dezash123/watch-pcb/mainboard/watch-pcb.kicad_pcb

## KiCad design mainboard/watch-pcb.kicad_pcb (2025-09-04)

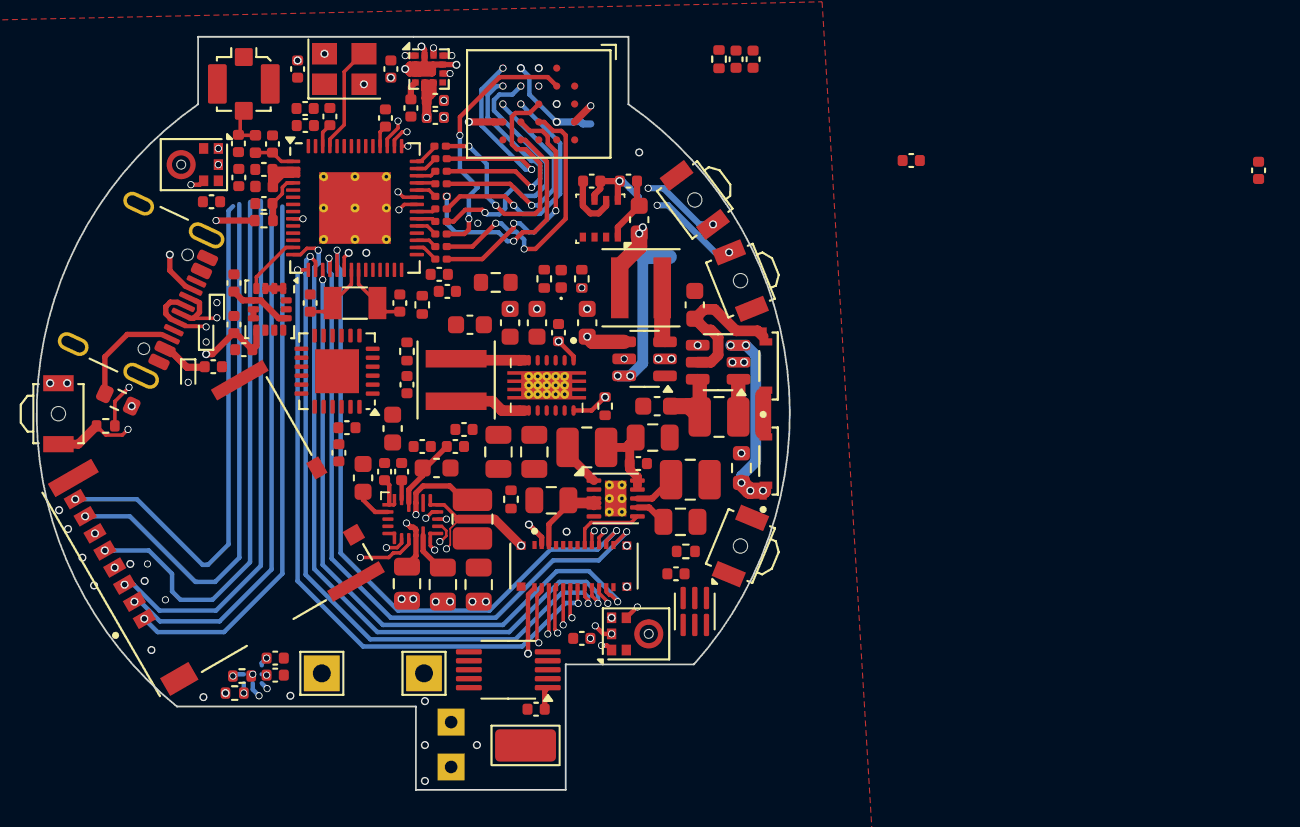
[picture p1: board watch-pcb.kicad_pcb from above]

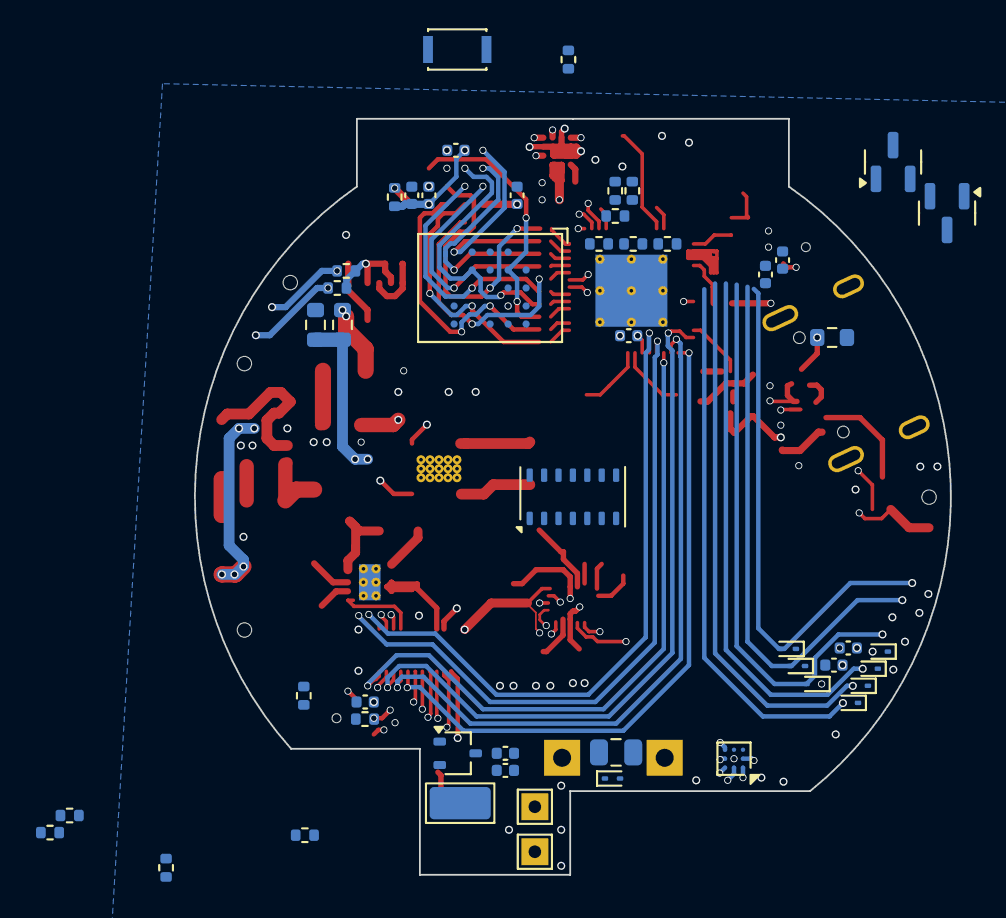
[picture p2: board watch-pcb.kicad_pcb from below]

Board: 6 copper layers, 42.0 x 42.0 mm, 179 parts (50 on the bottom side), 116 nets.

Parts:
C1, C4, C9, C17, C19, C23, C27, C41, C44, C48, C52, C70, C72, C75, C78: 1uF; C_0402_1005Metric
C2, C10, C11, C13, C14, C16, C24, C25, C26, C28, C29, C30, C35, C45, C50, C54, C56, C59, C61, C62, C67, C68, C69, C71, C74, C76, C77: 100nF; C_0402_1005Metric
C3, C84: 10uF; C_0603_1608Metric
C5: 47nF; C_0402_1005Metric
C6, C7, C8: 22uF; C_0603_1608Metric
C12, C73, C81: 4.7uF; C_0603_1608Metric
C15, C55, C57, C58, C64, C65, C79, C80: 10uF; C_0805_2012Metric
C18, C33: 10nF; C_0402_1005Metric
C20: 2.2uF; C_0402_1005Metric
C21, C22: 1.5pF; C_0402_1005Metric
C31, C32, C46, C47: C; C_0402_1005Metric
C34, C60: 10uF; C_0402_1005Metric
C51: 1uF; C_0603_1608Metric
C63: 22uF; C_0805_2012Metric
C82: 220nF; C_0603_1608Metric
D1, D2: CUW Y3SH.B2-JD-42-6T; LED_CUW_Y3SH.B2-GFJD-5J6T-Z242-20-R18-Z
D3, D6, D7, D8: ESD9B5.0ST5G; D_SOD-923
D4: CHARGING; LED_0402_1005Metric
D9, D10, D11, D12, D13, D14, D15: ESD9B3.3ST5G; D_SOD-923
J2: USB_C_Receptacle; USB_C_Receptacle_GCT_USB4105-xx-A_16P_TopMnt_Horizontal
J3: ESP_ANT; U.FL_Molex_MCRF_73412-0110_Vertical
J5: Micro_SD_Card; MOLEX_503398-1892
J6: TT143AMC12C; MOLEX_505550-2420
J7: BATT+; TestPoint_THTPad_2.0x2.0mm_Drill1.0mm
J8: BATT-; TestPoint_THTPad_2.0x2.0mm_Drill1.0mm
J9: LASER+; TestPoint_Keystone_5015_Micro_Mini
J10: LASER-; TestPoint_Keystone_5015_Micro_Mini
J11: MTR+; TestPoint_THTPad_1.5x1.5mm_Drill0.7mm
J13: MTR-; TestPoint_THTPad_1.5x1.5mm_Drill0.7mm
L1: XFL4020-152ME; L_Coilcraft_XxL4040
L2: CIGT252010EH1R0MNE; L_1008_2520Metric
L3: XFL4020-222ME; L_Coilcraft_XxL4040
L4: 2.7nH; L_0402_1005Metric
L5: LQG15HN2N0C02D; L_0402_1005Metric
L6: 24nH; C_0402_1005Metric
L7, L8: 10uH; L_1008_2520Metric
L9: LQM2HPN4R7MG0L; L_1008_2520Metric
MK1, MK2: ICS-43434; InvenSense_ICS-43434-6_3.5x2.65mm
Q1: BSS214NW; SOT-323_SC-70
Q2, Q3: BSS138; SOT-23
R1, R18, R23, R24, R38, R39, R40, R41, R42, R43: 10k; R_0402_1005Metric
R4: 5; R_0603_1608Metric
R5, R14, R15, R17, R19, R20, R45, R46, R47, R48, R49: 100k; R_0402_1005Metric
R8, R35, R37, R44, R50, R51, R52, R53, R54, R55: 0; R_0201_0603Metric
R9: 5k; R_0402_1005Metric
R10: 1M; R_0402_1005Metric
R11: 5.32k; R_0402_1005Metric
R12: 30.1; R_0402_1005Metric
R13: R; R_0402_1005Metric
R16, R22: 5.1k; R_0603_1608Metric
R26: 0; R_0402_1005Metric
R28: 200k; R_0603_1608Metric
R29: 100k; R_0603_1608Metric
R30: 499k; R_0402_1005Metric
R36: 1k; C_0402_1005Metric
SW1, SW2, SW3, SW4: B3U-3000P-B; SW_SPST_B3U-3000P-B
SW8: BOOT; SW_SPST_CK_KXT3
TH1: 103AT-2 10k; R_0603_1608Metric
U1: TPS63021; Texas_VSON-14_3x4mm_ThermalPad
U2: BQ25628E; Texas_WQFN-18_2.5x3.0mm_P0.4mm
U3: BME280; Bosch_LGA-8_2.5x2.5mm_P0.65mm_ClockwisePinNumbering
U4: BQ27427YZFR; Texas_DSBGA-9_1.62x1.58mm_Layout3x3_P0.5mm
U5: MX25UM51245GXDI00; BGA-24_6.0x8.0mm_Layout5x5_P1.0mm
U6: S80KS5123GABHV020; BGA-24_6.0x8.0mm_Layout5x5_P1.0mm
U8: TCA9535MRGER; VQFN-24-1EP_4x4mm_P0.5mm_EP2.45x2.45mm
U9: TPS65631W; WSON-10-1EP_2.5x2.5mm_P0.5mm_EP1.2x2mm_ThermalVias
U10: LIS3MDL; LGA-12_2x2mm_P0.5mm
U11: ESP32-S3; QFN-56-1EP_7x7mm_P0.4mm_EP4x4mm_ThermalVias
U12: LSM6DSOXTR; LGA-14_3x2.5mm_P0.5mm_LayoutBorder3x4y
U13: DRV2605LDGS; VSSOP-10_3x3mm_P0.5mm
U14: MAX30102; Maxim_OLGA-14_3.3x5.6mm_P0.8mm
U15: APDS-9306-065; Broadcom_DFN-6_2x2mm_P0.65mm
U16: AP3019AK; SOT-23-6
U17: TLV62569DDC; SOT-23-6
Y1: 32.768kHz; Crystal_SMD_3215-2Pin_3.2x1.5mm
Y2: 40MHz(10ppm); Crystal_SMD_3225-4Pin_3.2x2.5mm

Connections:
+1V8: C9.1, C10.1, C23.1, C24.2, C25.1, C26.1, C27.1, C28.1, C29.1, C30.1, C72.2, C76.2, C84.2, L3.2, R19.1, R20.1, R28.1, U5.B4 (VCC), U5.D1 (VCCQ), U5.E4 (VCCQ), U6.B4 (VCC), U6.D1 (VCCQ), U6.E4 (VCCQ), U11.29 (VDD_SPI), U14.11 (VDD)
+3V3: C4.1, C6.2, C7.2, C8.2, C11.1, C13.1, C16.1, C17.1, C33.1, C34.1, C44.2, C45.1, C48.2, C50.2, C52.2, C54.1, C55.2, C56.1, C60.2, C61.2, C62.1, C67.2, C68.2, C69.2, C70.2, C73.1, C74.1, C77.1, D15.2 (A2), J5.4 (VDD), J6.1 (VDD), J6.19 (IOVCC), J6.20 (VDD), J9.1, L5.2, L7.1, MK1.5 (VDD), MK2.2 (LR), MK2.5 (VDD), R5.2, R10.1, R13.2, R15.2, R17.2, R24.2, R38.1, R39.1, R40.1, R41.1, R42.1, R43.1, R46.1, R47.1, R48.1, R49.1, SW8.1, U1.3 (FB), U1.4 (VOUT), U1.5 (VOUT), U3.2 (CSB), U3.6 (VDDIO), U3.8 (VDD), U8.21 (VCC), U9.9 (AVIN), U9.10 (PVIN), U10.5 (Vdd), U10.6 (Vdd_IO), U10.10 (~CS), U11.20 (VDD3P3_RTC), U11.46 (VDD3P3_CPU), U11.55 (VDDA), U11.56 (VDDA), U12.5 (VDDIO), U12.8 (VDD), U12.12 (CS), U14.9 (VLED+), U14.10 (VLED+), U15.3 (VDD)
+BATT: C15.2, C19.2, C63.1, D3.2 (A2), J7.1, U2.8 (BAT), U4.C3 (BAT)
+VSW: C2.2, C51.1, C64.1, C65.1, C71.2, C75.1, C79.1, C80.1, C81.1, L2.2, L9.2, R30.2, U1.1 (VINA), U1.10 (VIN), U1.11 (VIN), U2.9 (SYS), U4.C2 (SRX), U13.6 (VDD/NC), U13.10 (VDD), U16.6 (V_{IN}), U17.1 (EN), U17.4 (VIN)
/ESP MCU/BOOT: Q2.1 (G), Q3.1 (G), R1.2, SW8.2
/ESP MCU/CLK_N: C47.2, U11.53 (XTAL_N), Y2.3
/ESP MCU/CLK_P: L6.2, U11.54 (XTAL_P)
/ESP MCU/EN: R10.2, R23.1, U1.14 (PG)
/ESP MCU/ESP_ANT: C22.1, L4.2, U11.1 (LNA_IN)
/ESP MCU/EXT_INT: R24.1, U8.22 (~INT), U11.27 (GPIO21)
/ESP MCU/EXT_IO1: U8.1 (P00), U13.5 (EN)
/ESP MCU/EXT_IO2: J6.5 (RST), U8.2 (P01)
/ESP MCU/EXT_IO3: J6.15 (RST), U8.3 (P02)
/ESP MCU/EXT_IO4: U8.4 (P03), U12.9 (INT2)
/ESP MCU/EXT_IO5: R47.2, SW2.1, U8.5 (P04)
/ESP MCU/EXT_IO6: R48.2, SW3.2, U8.6 (P05)
/ESP MCU/EXT_IO7: R49.2, SW4.1, U8.7 (P06)
/ESP MCU/EXT_IO8: R5.1, U8.8 (P07), U15.4 (INT)
/ESP MCU/EXT_IO9: U8.10, U10.7 (INT)
/ESP MCU/EXT_IO10: R14.1, U1.13 (PS/SYNC), U8.11
/ESP MCU/EXT_IO11: R15.1, U2.11 (INT), U8.12
/ESP MCU/EXT_IO12: R17.1, U4.A1 (GPOUT), U8.13
/ESP MCU/FSPI_CLK: J6.11 (SCL), U11.17 (GPIO12)
/ESP MCU/FSPI_CS: J6.7 (CS), U11.15 (GPIO10)
/ESP MCU/FSPI_D: J6.8 (D0), U11.16 (GPIO11)
/ESP MCU/FSPI_HD: J6.9 (D3), U11.14 (GPIO9)
/ESP MCU/FSPI_Q: J6.13 (D1), U11.18 (GPIO13)
/ESP MCU/FSPI_WP: J6.14 (D2), U11.19 (GPIO14)
/ESP MCU/I2S_SCK: MK1.4 (SCK), MK2.4 (SCK), U11.45 (MTDO)
/ESP MCU/I2S_SD: MK1.6 (SD), MK2.6 (SD), R45.2, U11.43 (GPIO38)
/ESP MCU/I2S_WS: MK1.1 (WS), MK2.1 (WS), U11.44 (MTCK)
/ESP MCU/IO1: R26.2, U11.9 (GPIO4)
/ESP MCU/IO2: J6.2 (INT), U11.10 (GPIO5)
/ESP MCU/IO3: J6.16 (TE), U11.11 (GPIO6)
/ESP MCU/IO4: R46.2, U11.12 (GPIO7), U14.13 (~INT)
/ESP MCU/IO5: U11.13 (GPIO8), U12.4 (INT1)
/ESP MCU/IO6: R36.1, U11.23 (GPIO17)
/ESP MCU/IO8: U10.8 (DRDY), U11.37 (SPICLK_P)
/ESP MCU/IO9: U11.36 (SPICLK_N), U16.4 (CTRL)
/ESP MCU/MCU_SCL: Q3.3 (D), U11.5 (GPIO0)
/ESP MCU/MEM_CLK: R52.2, U5.B2 (SCLK), U6.B2 (CK)
/ESP MCU/MEM_CS0: U5.C2 (CS#), U11.32 (SPICS0)
/ESP MCU/MEM_CS1: U6.A3 (CS#), U11.28 (SPICS1)
/ESP MCU/MEM_D0: R54.2, U5.D3 (SIO0), U6.D3 (DQ0)
/ESP MCU/MEM_D1: R53.2, U5.D2 (SIO1), U6.D2 (DQ1)
/ESP MCU/MEM_D2: R51.2, U5.C4 (SIO2), U6.C4 (DQ2)
/ESP MCU/MEM_D3: R50.2, U5.D4 (SIO3), U6.D4 (DQ3)
/ESP MCU/MEM_D4: R8.2, U5.D5 (SIO4), U6.D5 (DQ4)
/ESP MCU/MEM_D5: R35.2, U5.E3 (SIO5), U6.E3 (DQ5)
/ESP MCU/MEM_D6: R37.2, U5.E2 (SIO6), U6.E2 (DQ6)
/ESP MCU/MEM_D7: R44.2, U5.E1 (SIO7), U6.E1 (DQ7)
/ESP MCU/MEM_DQS: R55.2, U5.C3 (DQS), U6.C3 (RWDS)
/ESP MCU/RTC_N: C32.2, U11.22 (XTAL_32K_N), Y1.1
/ESP MCU/RTC_P: C31.2, U11.21 (XTAL_32K_P), Y1.2
/ESP MCU/SD_CLK: D12.2 (A2), J5.5 (CLK), R41.2, U11.50 (U0RXD)
/ESP MCU/SD_CMD: D11.2 (A2), J5.3 (CMD), R40.2, U11.49 (U0TXD)
/ESP MCU/SD_D0: D13.2 (A2), J5.7 (DAT0), R42.2, U11.51 (GPIO45)
/ESP MCU/SD_D1: D14.2 (A2), J5.8 (DAT1), Q2.3 (D), R43.2, U11.52 (GPIO46)
/ESP MCU/SD_D2: D9.2 (A2), J5.1 (DAT2), R38.2, U11.47 (MTDI)
/ESP MCU/SD_D3: D10.2 (A2), J5.2 (DAT3/CD), R39.2, U11.48 (MTMS)
/ESP MCU/USB_D+: D7.2 (A2), J2.A6 (D+), J2.B6 (D+), U11.26 (GPIO20/USB_D+)
/ESP MCU/USB_D-: D8.2 (A2), J2.A7 (D-), J2.B7 (D-), U11.25 (GPIO19/USB_D-)
/IO/AMOLED_M: C58.2, J6.23 (ELVSS), U9.7 (OUTN)
/IO/AMOLED_P: C57.2, J6.22 (ELVDD), U9.3 (OUTP), U9.4 (FBS)
/IO/SWIRE: J6.17 (SWIRE), U9.6 (CTRL)
/USB and Power/1V8G: R30.1, U1.12 (EN), U17.5 (PG)
/USB and Power/SCL: U2.13 (SCL), U4.A3 (SCL)
/USB and Power/SDA: U2.12 (SDA), U4.A2 (SDA)
GND: C1.2, C2.1, C3.1, C4.2, C6.1, C7.1, C8.1, C9.2, C10.2, C11.2, C12.2, C13.2, C14.2, C15.1, C16.2, C17.2, C18.2, C19.1, C20.1, C21.2, C22.2, C23.2, C24.1, C25.2, C26.2, C27.2, C28.2, C29.2, C30.2, C31.1, C32.1, C33.2, C34.2, C35.2, C41.2, C44.1, C45.2, C46.2, C47.1, C48.1, C50.1, C51.2, C52.1, C54.2, C55.1, C56.2, C57.1, C58.1, C59.1, C60.1, C61.1, C62.2, C63.2, C64.2, C65.2, C67.1, C68.1, C69.1, C70.1, C71.1, C72.1, C73.2, C74.2, C75.2, C76.1, C77.2, C78.2, C79.2, C80.2, C81.2, C82.2, C84.1, D3.1 (A1), D6.2 (A2), D7.1 (A1), D8.1 (A1), D9.1 (A1), D10.1 (A1), D11.1 (A1), D12.1 (A1), D13.1 (A1), D14.1 (A1), D15.1 (A1), J2.A1 (GND), J2.A12 (GND), J2.B1 (GND), J2.B12 (GND), J2.S1 (SHIELD), J3.2 (Ext), J5.6 (VSS), J5.9 (SHIELD), J6.6 (GND), J6.10 (GND), J6.12 (GND), J6.18 (GND), J6.24 (MTP_PWR), J6.SH (SHIELD), J8.1, L8.1, MK1.2 (LR), MK1.3 (GND), MK2.3 (GND), Q1.2 (S), Q2.2 (S), Q3.2 (S), R1.1, R4.2, R9.2, R12.1, R14.2, R16.2, R18.1, R22.2, R29.2, R45.1, SW1.2, SW2.2, SW3.1, SW4.2, TH1.1, U1.2 (GND), U1.15 (PGND), U2.14 (CE), U2.15 (GND), U3.1 (GND), U3.5 (SDO), U3.7 (GND), U4.B2 (VSS), U4.C1 (VSS), U5.B3 (GND), U5.C1 (VSSQ), U5.E5 (VSSQ), U6.B1 (CK#), U6.B3 (VSS), U6.C1 (VSSQ), U6.E5 (VSSQ), U8.9 (GND), U8.18 (A0), U8.23 (A1), U8.24 (A2), U8.25 (EPAD), U9.2 (PGND), U9.5 (AGND), U9.11 (GND), U10.2 (GND), U10.3 (GND), U10.9 (SDO/SA1), U10.12 (GND), U11.57 (GND), U12.1 (SDO/SA0), U12.2 (SDX), U12.3 (SCX), U12.6 (GND), U12.7 (GND__1), U13.4 (IN/TRIG), U13.8 (GND), U14.4 (PGND), U14.12 (GND), U15.6 (GND), U16.2 (GND), U17.2 (GND), Y2.2, Y2.4
unnamed: C14.1, L5.1, U11.2 (VDD3P3), U11.3 (VDD3P3)
unnamed: C46.1, L6.1, Y2.1
unnamed: C82.1, D1.2 (A), U16.5 (V_{OUT})
unnamed: D1.1 (K), D2.2 (A)
unnamed: D2.1 (K), R4.1, U16.3 (FB)
unnamed: D4.2 (A), R13.1
unnamed: D4.1 (K), U2.10 (STAT)
unnamed: J2.A5 (CC1), R16.1
unnamed: J2.B5 (CC2), R22.1
unnamed: C21.1, J3.1 (In), L4.1
unnamed: J10.1, Q1.3 (D)
unnamed: J11.1, U13.7 (OUT+)
unnamed: J13.1, U13.9 (OUT-)
unnamed: L1.1, U1.8 (L1), U1.9 (L1)
unnamed: L1.2, U1.6 (L2), U1.7 (L2)
unnamed: Q1.1 (G), R36.2
unnamed: C5.1, U2.1 (BTST)
unnamed: R9.1, U2.4 (ILIM)
unnamed: C3.2, C35.1, U2.17 (PMID)
unnamed: R26.1, SW1.1, U2.7 (QON)
unnamed: C12.1, U2.2 (REGN)
unnamed: C5.2, L2.1, U2.16 (SW)
unnamed: R11.1, R12.2, TH1.2, U2.6 (TS)
unnamed: R11.2, U2.5 (TS_BIAS)
unnamed: R18.2, U4.B1 (BIN)
unnamed: C20.2, U4.B3 (VDD)
unnamed: R20.2, U5.A4 (RESET#)
unnamed: R19.2, U6.A4 (RST#)
unnamed: L8.2, U9.8 (SWN)
unnamed: L7.2, U9.1 (SWP)
unnamed: C59.2, U10.4 (C1)
unnamed: C41.1, R23.2, U11.4 (CHIP_PU)
unnamed: R8.1, U11.38 (GPIO33)
unnamed: R35.1, U11.39 (GPIO34)
unnamed: R37.1, U11.40 (GPIO35)
unnamed: R44.1, U11.41 (GPIO36)
unnamed: R55.1, U11.42 (GPIO37)
unnamed: R52.1, U11.33 (SPICLK)
unnamed: R54.1, U11.35 (SPID)
unnamed: R50.1, U11.30 (SPIHD)
unnamed: R53.1, U11.34 (SPIQ)
unnamed: R51.1, U11.31 (SPIWP)
unnamed: C78.1, U13.1 (REG)
unnamed: L9.1, U16.1 (SW)
unnamed: R28.2, R29.1, U17.6 (FB)
unnamed: L3.1, U17.3 (SW)
VBUS: C1.1, C18.1, D6.1 (A1), J2.A4 (VBUS), J2.A9 (VBUS), J2.B4 (VBUS), J2.B9 (VBUS), U2.18 (VBUS)
