dezash123/watch-pcb/(commit log)

2025-03-08 adding existing progress/reorganization
    [AFE4420YZT.step, APS256XXN-OBR-BG.stp, LSM6DSOXTR.step, MAX30102EFD_T.step, MX25LM51245GXDI00.step, TPS63021DSJR.step, daughter-board.kicad_pcb, daughter-board.kicad_sch]
2025-03-10 done with stm, going back to esp
    [io.kicad_sch, stm_mcu.kicad_sch]
2025-03-12 quicksaving pcb bc im gonna redo it
    [PG-BGA-24-801.step, esp_mcu.kicad_sch, io.kicad_sch, usb_power.kicad_sch, watch-pcb.kicad_sch]
2025-03-13 no more daughter probably
    [esp_mcu.kicad_sch, io.kicad_sch, usb_power.kicad_sch, watch-pcb.kicad_pcb, watch-pcb.kicad_sch]
2025-03-23 basically done with board layout, gonna try to do a smaller one (47->42mm diameter)
    [B3U-3000P.step, XFL4020-152MEB.stp, esp_mcu.kicad_sch, io.kicad_sch, usb_power.kicad_sch, watch-pcb.kicad_pcb, watch-pcb.kicad_sch]
2025-05-15 layout done probably
    [esp_mcu.kicad_sch, io.kicad_sch, usb_power.kicad_sch, watch-pcb.kicad_sch]
2025-06-29 finally routed the memory :D
    [0734120110.stp, 503398-1892.step, 5055502420.stp, IND_TAIYO_NRS4018_TAY.step, OSRAM CUW Y3SH.B2.step, bom.csv, designators.csv, esp_mcu.kicad_sch]
2025-09-04 old changes
    [watch-pcb.kicad_pcb]
2025-09-04 clean heavily
    [bom.csv, designators.csv, esp_mcu.kicad_sch, freerouting.dsn, io.kicad_sch, mcu_mem.kicad_sch, positions.csv, stm_mcu.kicad_sch]
